IdealFox/Type_C-SSD-Box/复刻文件及说明/复刻文件/相关文档及技术手册/JMS583_cn.jpg

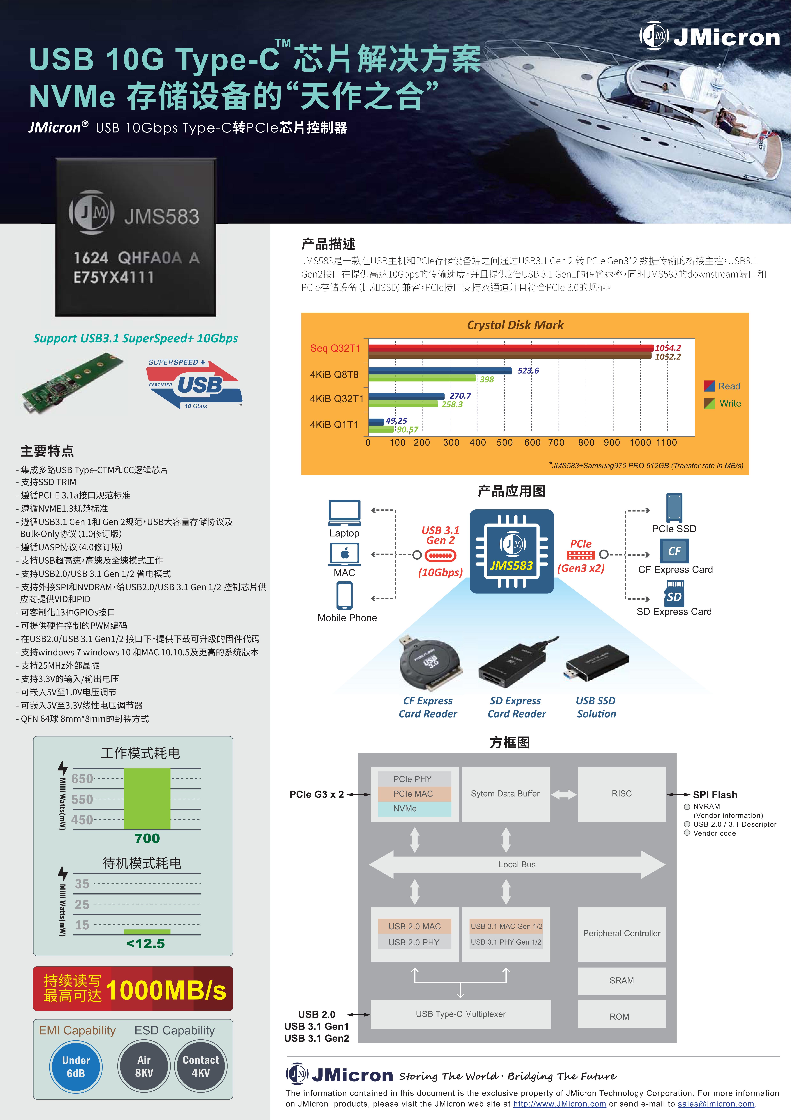
复刻文件及说明/复刻文件/相关文档及技术手册/JMS583_cn.jpg
