IdealFox/Type_C-SSD-Box/复刻文件及说明/复刻文件/所需器件/tb_image_share_1767597438001.png

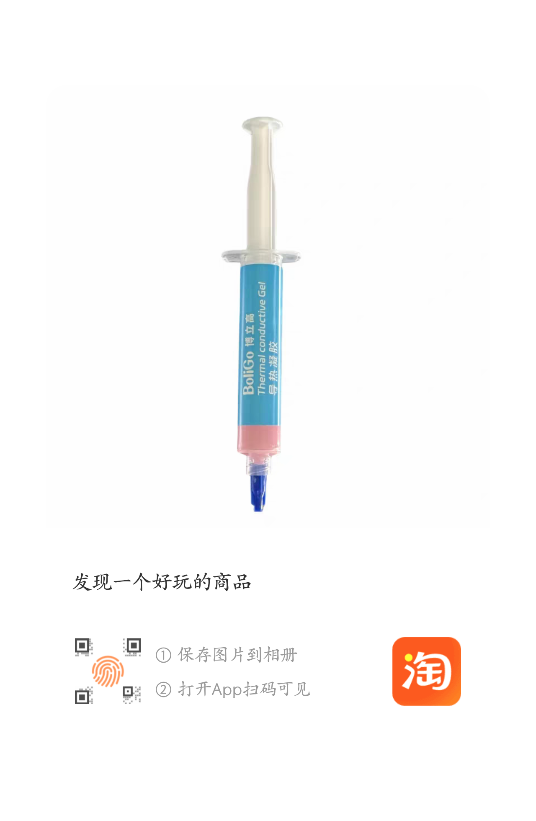
复刻文件及说明/复刻文件/所需器件/tb_image_share_1767597438001.png
