IdealFox/Type_C-SSD-Box/复刻文件及说明/复刻文件/所需器件/tb_image_share_1767601659125.png

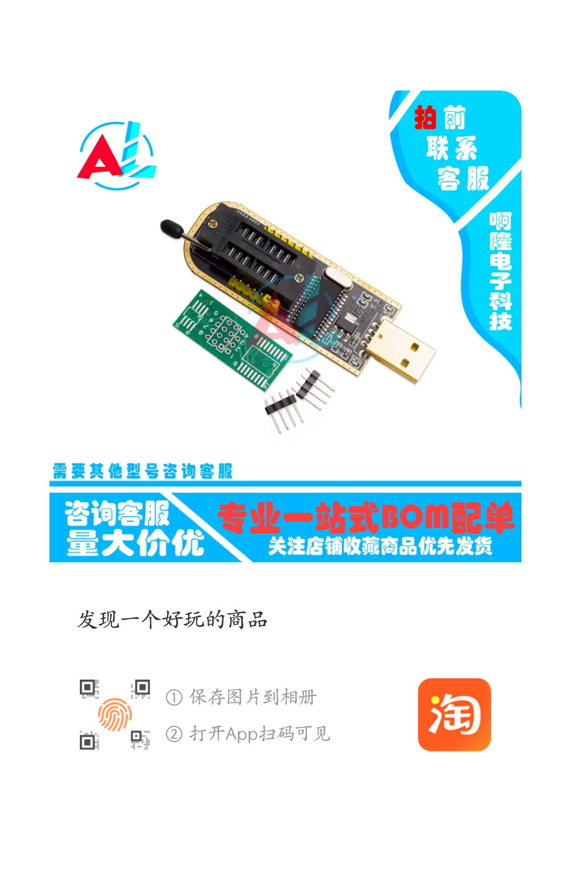
复刻文件及说明/复刻文件/所需器件/tb_image_share_1767601659125.png
