IdealFox/Type_C-SSD-Box/复刻文件及说明/复刻文件/所需器件/_Type_C硬盘盒_2025-09-27_14-32-02-立创_20260105.xls

立创商城BOM报价单
BOM配单编号：BOM260105002363 |  |  |  |  | 上传时间：2026-01-05 14:12:45 |  |  |  | 1.名称释义：MPQ--最小包装量；MOQ--最小起订量； 2.匹配结果为实时查询结果，库存和价格可能会有波动。如超过24小时，请在立创商城重新匹配后下单； 3.订货商品的价格仅供参考，请提交订单后确定。 4.如有部分物料未能成功匹配，需要整单购买，请联系商城客服。
BOM名称：_Type_C硬盘盒_2025-09-27_14-32-02 |  |  |  |  | 采购套数：5
商品总价:￥104.07 (原价:￥107.58, 折扣:-￥3.51) 注：报价单总价不含待确认和无法匹配项 |  |  |  |  | 网址：https://bom.szlcsc.com/bom.html
原始需求 |  |  |  |  |  |  |  |  | 匹配结果 |  |  |  |  |  |  | 订单满足
ID | Name Manufacturer Part | Designator | Footprint | Quantity | Manufacturer Part | Manufacturer | Supplier | Supplier Part | 匹配结果 | 商品名称 | 型号 | 品牌 | 封装 | 参数 | 目录 | 商品编号 | 商品链接 | 渠道 | 交期 | MOQ | MPQ | 库存 | 购买数量 | 单价(RMB) | 关税 | 小计(RMB) | 备注
1 | U261-241N-4BS60 U261-241N-4BS60 | USB1 | USB-TYPE-C-SMD_U261-241N-4BS60 | 1 | U261-241N-4BS60 | XKB Connection(中国星坤) | LCSC | C319150 | 系统匹配 | Type-C 公 夹板 | U261-241N-4BS60 | XKB Connection(中国星坤) | SMD | 连接器类型：Type-C 公母：公 安装方式：夹板 触点数量：24P 端口数量：1 额定电流 - 电源：5A 工作温度：-40℃~+85℃ | 连接器 | C319150 | https://item.szlcsc.com/300242.html | 现货 | 4小时内发货 | 7 | 56 | 6734 | 7 | 1.6926 | 0 | 11.85
2 | JMS583 | U6 | QFN-64_L8.0-W8.0-P0.40-TL-EP6.0 | 1 |  |  |  |  | 无法匹配
3 | MLD-NGFF-M-3.2H MLD-NGFF-M-3.2H | U1 | CONN-SMD_MLD-NGFF-M-3.2H | 1 | MLD-NGFF-M-3.2H | Minlenda(敏连达) | LCSC | C52766481 | 系统匹配 | NGFF M.2 M KEY 3.2H | MLD-NGFF-M-3.2H | Minlenda(敏连达) | SMD |  | 连接器 | C52766481 | https://item.szlcsc.com/55672808.html | 现货 | 4小时内发货 | 1 | 1200 | 1168 | 5 | 2.72 | 0 | 13.60
4 | BLM21PG600SN1D BLM21PG600SN1D | L1 | L0805 | 1 | BLM21PG600SN1D | muRata(村田) | LCSC | C18305 | 系统匹配 | 单路 0805磁珠 阻抗60Ω@100MHz | BLM21PG600SN1D | muRata(村田) | 0805 | 阻抗@频率：60Ω@100MHz 误差：±25% 直流电阻(DCR)：20mΩ | 磁珠/滤波器/EMI优化 | C18305 | https://item.szlcsc.com/19000.html | 现货 | 4小时内发货 | 50 | 4000 | 382500 | 50 | 0.1122 | 0 | 5.61
5 | 10uF CL10A106KP8NNNC | C1,C16,C23,C19,C9,C31,C30,C27,C26,C55 | C0603 | 10 | CL10A106KP8NNNC | SAMSUNG(三星) | LCSC | C19702 | 系统匹配 | 10uF ±10% 10V | CL10A106KP8NNNC | SAMSUNG(三星) | 0603 | 容值：10uF 精度：±10% 额定电压：10V 温度系数：X5R | 电容 | C19702 | https://item.szlcsc.com/20411.html | 现货 | 4小时内发货 | 50 | 4000 | 10975150 | 50 | 0.0369 | 0 | 1.85
6 | 220nF CL05B224KO5NNNC | C12,C13,C14,C15 | C0402 | 4 | CL05B224KO5NNNC | SAMSUNG(三星) | LCSC | C16772 | 系统匹配 | 220nF ±10% 16V | CL05B224KO5NNNC | SAMSUNG(三星) | 0402 | 容值：220nF 精度：±10% 额定电压：16V 温度系数：X7R | 电容 | C16772 | https://item.szlcsc.com/17456.html | 现货 | 4小时内发货 | 100 | 10000 | 474800 | 100 | 0.0277 | 0 | 2.77
7 | 330pF CL05C331JB5NNNC | C4,C5 | C0402 | 2 | CL05C331JB5NNNC | SAMSUNG(三星) | LCSC | C13533 | 系统匹配 | 330pF ±5% 50V | CL05C331JB5NNNC | SAMSUNG(三星) | 0402 | 容值：330pF 精度：±5% 额定电压：50V 温度系数：C0G | 电容 | C13533 | https://item.szlcsc.com/14182.html | 现货 | 4小时内发货 | 50 | 10000 | 156100 | 50 | 0.0186 | 0 | 0.93
8 | 100nF CL05B104KO5NNNC | C6,C7,C10,C11,C46,C47,C45,C44,C43,C42,C50,C49,C48,C53,C52,C51,C24,C20,C37,C38,C35,C39,C36,C32,C29,C28,C25,C17,C3,C18,C56 | C0402 | 31 | CL05B104KO5NNNC | SAMSUNG(三星) | LCSC | C1525 | 系统匹配 | 100nF ±10% 16V | CL05B104KO5NNNC | SAMSUNG(三星) | 0402 | 容值：100nF 精度：±10% 额定电压：16V 温度系数：X7R | 电容 | C1525 | https://item.szlcsc.com/1877.html | 现货 | 4小时内发货 | 100 | 10000 | 25851200 | 200 | 0.0076 | 0 | 1.52
9 | 25MHz XL2EL89CSI-111YLC-25M | X1 | CRYSTAL-SMD_4P-L3.2-W2.5-BL | 1 | XL2EL89CSI-111YLC-25M | YXC(扬兴晶振) | LCSC | C5280577 | 系统匹配 | YSX321SL 25MHZ 4P 3225 20PF ±10PPM -40~85℃ (±20PPM) | XL2EL89CSI-111YLC-25M | YXC(扬兴晶振) | SMD3225-4P | 晶振类型：贴片晶振 频率：25MHz 常温频差：±10ppm 负载电容：20pF 频率稳定度：±20ppm | 振荡器/谐振器 | C5280577 | https://item.szlcsc.com/6016759.html | 现货 | 4小时内发货 | 10 | 3000 | 139070 | 10 | 0.3869 | 0 | 3.87
10 | 20pF 0402CG200J500NT | C8,C2 | C0402 | 2 | 0402CG200J500NT | FH(风华) | LCSC | C1554 | 系统匹配 | 20pF ±5% 50V | 0402CG200J500NT | FH(风华) | 0402 | 容值：20pF 精度：±5% 额定电压：50V 温度系数：C0G | 电容 | C1554 | https://item.szlcsc.com/1906.html | 现货 | 4小时内发货 | 100 | 10000 | 685600 | 100 | 0.0066 | 0 | 0.66
11 | XL-1608PGC-06 XL-1608PGC-06 | U3,U2 | LED0603-RD_GREEN | 2 | XL-1608PGC-06 | XINGLIGHT(成兴光) | LCSC | C7371905 | 系统匹配 | 0603加粉翠绿0.6T贴片式发光二极管 | XL-1608PGC-06 | XINGLIGHT(成兴光) | 0603 | 发光颜色：翠绿色 正向压降(Vf)：2.6V~3V 波长：515nm~530nm 二极管配置：独立二极管 透镜颜色：绿色透镜 发光强度：900mcd 发光角度：120° 载带方式：正贴 | 光电器件 | C7371905 | https://item.szlcsc.com/8342977.html | 现货 | 4小时内发货 | 50 | 20000 | 229350 | 50 | 0.0622 | 0 | 3.11
12 | XL-1608UBC-06A XL-1608UBC-06A | U5 | LED0603-R-RD | 1 | XL-1608UBC-06A | XINGLIGHT(成兴光) | LCSC | C7371904 | 系统匹配 | 0603高亮蓝0.6T贴片式发光二极管 | XL-1608UBC-06A | XINGLIGHT(成兴光) | 0603 | 发光颜色：蓝色 正向压降(Vf)：2.6V~3V 功率：100mW 正向电流：5mA 波长：456nm~476nm 透镜颜色：无色透明透镜 发光强度：300mcd 发光角度：130° 载带方式：正贴 工作温度：-40℃~+85℃ | 光电器件 | C7371904 | https://item.szlcsc.com/8342976.html | 现货 | 4小时内发货 | 50 | 4000 | 83200 | 50 | 0.0777 | 0 | 3.89
13 | 10kΩ 0402WGF1002TCE | R6,R7,R4 | R0402 | 3 | 0402WGF1002TCE | UNI-ROYAL(厚声) | LCSC | C25744 | 系统匹配 | 10kΩ ±1% 62.5mW 厚膜电阻 | 0402WGF1002TCE | UNI-ROYAL(厚声) | 0402 | 电阻类型：厚膜电阻 阻值：10kΩ 精度：±1% 功率：62.5mW 工作电压：50V 温度系数：±100ppm/℃ | 电阻 | C25744 | https://item.szlcsc.com/26487.html | 现货 | 4小时内发货 | 100 | 10000 | 2763700 | 100 | 0.0033 | 0 | 0.33
14 | 4.7kΩ 0402WGF4701TCE | R1,R3 | R0402 | 2 | 0402WGF4701TCE | UNI-ROYAL(厚声) | LCSC | C25900 | 系统匹配 | 4.7kΩ ±1% 62.5mW 厚膜电阻 | 0402WGF4701TCE | UNI-ROYAL(厚声) | 0402 | 电阻类型：厚膜电阻 阻值：4.7kΩ 精度：±1% 功率：62.5mW 工作电压：50V 温度系数：±100ppm/℃ | 电阻 | C25900 | https://item.szlcsc.com/26643.html | 现货 | 4小时内发货 | 100 | 10000 | 6897500 | 100 | 0.0034 | 0 | 0.34
15 | 12kΩ 0402WGF1202TCE | R5 | R0402 | 1 | 0402WGF1202TCE | UNI-ROYAL(厚声) | LCSC | C25752 | 系统匹配 | 12kΩ ±1% 62.5mW 厚膜电阻 | 0402WGF1202TCE | UNI-ROYAL(厚声) | 0402 | 电阻类型：厚膜电阻 阻值：12kΩ 精度：±1% 功率：62.5mW 工作电压：50V 温度系数：±100ppm/℃ | 电阻 | C25752 | https://item.szlcsc.com/26495.html | 现货 | 4小时内发货 | 100 | 10000 | 453900 | 100 | 0.0036 | 0 | 0.36
16 | 4.7uF CL10A475KO8NNNC | C40,C41 | C0603 | 2 | CL10A475KO8NNNC | SAMSUNG(三星) | LCSC | C19666 | 系统匹配 | 4.7uF ±10% 16V | CL10A475KO8NNNC | SAMSUNG(三星) | 0603 | 容值：4.7uF 精度：±10% 额定电压：16V 温度系数：X5R | 电容 | C19666 | https://item.szlcsc.com/20375.html | 现货 | 4小时内发货 | 10 | 4000 | 1390850 | 10 | 0.0612 | 0 | 0.61
17 | 1uF CL10A105KB8NNNC | C34,C33 | C0603 | 2 | CL10A105KB8NNNC | SAMSUNG(三星) | LCSC | C15849 | 系统匹配 | 1uF ±10% 50V | CL10A105KB8NNNC | SAMSUNG(三星) | 0603 | 容值：1uF 精度：±10% 额定电压：50V 温度系数：X5R | 电容 | C15849 | https://item.szlcsc.com/16531.html | 现货 | 4小时内发货 | 50 | 4000 | 9961300 | 50 | 0.0311 | 0 | 1.56
18 | 50kΩ RTT025002FTH | R2 | R0402 | 1 | RTT025002FTH | RALEC(旺诠) | LCSC | C166559 | 系统匹配 | 厚膜电阻 50kΩ ±1% 62.5mW | RTT025002FTH | RALEC(旺诠) | 0402 | 电阻类型：厚膜电阻 阻值：50kΩ 精度：±1% 功率：62.5mW 工作电压：50V 温度系数：±100ppm/℃ | 电阻 | C166559 | https://item.szlcsc.com/177942.html | 现货 | 4小时内发货 | 100 | 10000 | 41000 | 100 | 0.0038 | 0 | 0.38
19 | W25X20CLSNIG W25X20CLSNIG | U4 | SOIC-8_L5.0-W4.0-P1.27-LS6.0-BL | 1 | W25X20CLSNIG | Winbond(华邦) | LCSC | C409019 | 系统匹配 | 具有4KB扇区和双IO SPI接口的2Mbit 串行SPI闪存 | W25X20CLSNIG | Winbond(华邦) | SOIC-8 | 接口类型：SPI 存储容量：2Mbit 时钟频率(fc)：104MHz | 存储器 | C409019 | https://item.szlcsc.com/398848.html | 现货 | 4小时内发货 | 1 | 2500 | 35007 | 5 | 3.25 | 0 | 16.25
20 | ETA3409S2F ETA3409S2F | U8,U7 | SOT-23-5_L2.9-W1.6-P0.95-LS2.8-BL | 2 | ETA3409S2F | ETA(钰泰) | LCSC | C7465553 | 系统匹配 | 3A 1MHz 同步降压转换器 | ETA3409S2F | ETA(钰泰) | SOT23-5 | 功能类型：降压型 工作电压：2.4V~7.3V 输出电压：600mV~7.3V 输出电流：3A 输出类型：可调 | 电源管理 | C7465553 | https://item.szlcsc.com/8507090.html | 现货 | 4小时内发货 | 5 | 3000 | 25055 | 10 | 0.7326 | 0 | 7.33
21 | 2.2uH FTC252012S2R2MBCA | L4,L3 | IND-SMD_L2.5-W2.0_MHCHL2520 | 2 | FTC252012S2R2MBCA | cjiang(长江微电) | LCSC | C5832372 | 系统匹配 | 2.2uH ±20% 3.8A | FTC252012S2R2MBCA | cjiang(长江微电) | 1008 | 电感值：2.2uH 精度：±20% 额定电流：3A 饱和电流(Isat)：3.8A | 电感/线圈/变压器 | C5832372 | https://item.szlcsc.com/6763492.html | 现货 | 4小时内发货 | 20 | 3000 | 420640 | 20 | 0.2046 | 0 | 4.09
22 | 100kΩ 0402WGF1003TCE | R11,R10,R19 | R0402 | 3 | 0402WGF1003TCE | UNI-ROYAL(厚声) | LCSC | C25741 | 系统匹配 | 100kΩ ±1% 62.5mW 厚膜电阻 | 0402WGF1003TCE | UNI-ROYAL(厚声) | 0402 | 电阻类型：厚膜电阻 阻值：100kΩ 精度：±1% 功率：62.5mW 工作电压：50V 温度系数：±100ppm/℃ | 电阻 | C25741 | https://item.szlcsc.com/26484.html | 现货 | 4小时内发货 | 100 | 10000 | 3188300 | 100 | 0.0035 | 0 | 0.35
23 | 22.1kΩ 0402WGF2212TCE | R9 | R0402 | 1 | 0402WGF2212TCE | UNI-ROYAL(厚声) | LCSC | C43473 | 系统匹配 | 22.1kΩ ±1% 62.5mW 厚膜电阻 | 0402WGF2212TCE | UNI-ROYAL(厚声) | 0402 | 电阻类型：厚膜电阻 阻值：22.1kΩ 精度：±1% 功率：62.5mW 工作电压：50V 温度系数：±100ppm/℃ | 电阻 | C43473 | https://item.szlcsc.com/44464.html | 现货 | 4小时内发货 | 100 | 10000 | 171000 | 100 | 0.0035 | 0 | 0.35
24 | 22pF 0402CG220J500NT | C22,C21 | C0402 | 2 | 0402CG220J500NT | FH(风华) | LCSC | C1555 | 系统匹配 | 22pF ±5% 50V | 0402CG220J500NT | FH(风华) | 0402 | 容值：22pF 精度：±5% 额定电压：50V 温度系数：C0G | 电容 | C1555 | https://item.szlcsc.com/1907.html | 现货 | 4小时内发货 | 100 | 10000 | 752900 | 100 | 0.0065 | 0 | 0.65
25 | ZX-PZ1.0-1-4PZZ ZX-PZ1.0-1-4PZZ | H1 | HDR-TH_ZX-PZ1.0-1-4PZZ | 1 | ZX-PZ1.0-1-4PZZ | Megastar(兆星) | LCSC | C37328854 | 系统匹配 | 1x4P 间距:1mm 方针 直插 | ZX-PZ1.0-1-4PZZ | Megastar(兆星) | 插件,P=1mm | 插针结构：1x4P 间距：1mm 圆针/方针：方针 安装方式：直插 排数：单排 总PIN位数：4P 额定电流：750mA 配合针长度：2mm 塑高：1mm 端接针长度：2mm 触头材质：黄铜 触头镀层：金 工作温度：-40℃~+105℃ 颜色：黑色 | 连接器 | C37328854 | https://item.szlcsc.com/39053335.html | 现货 | 4小时内发货 | 5 | 2000 | 6435 | 5 | 0.31939 | 0 | 1.60
26 | 150kΩ 0402WGF1503TCE | R8 | R0402 | 1 | 0402WGF1503TCE | UNI-ROYAL(厚声) | LCSC | C25755 | 系统匹配 | 150kΩ ±1% 62.5mW 厚膜电阻 | 0402WGF1503TCE | UNI-ROYAL(厚声) | 0402 | 电阻类型：厚膜电阻 阻值：150kΩ 精度：±1% 功率：62.5mW 工作电压：50V 温度系数：±100ppm/℃ | 电阻 | C25755 | https://item.szlcsc.com/26498.html | 现货 | 4小时内发货 | 100 | 10000 | 318200 | 100 | 0.0035 | 0 | 0.35
27 | 4.7uH FTC252010S4R7MBCA | L2 | IND-SMD_L2.5-W2.0-VLS252012CX-150M | 1 | FTC252010S4R7MBCA | cjiang(长江微电) | LCSC | C5832360 | 系统匹配 | 4.7uH ±20% 2.6A | FTC252010S4R7MBCA | cjiang(长江微电) | 1008 | 电感值：4.7uH 精度：±20% 额定电流：2A 饱和电流(Isat)：2.6A | 电感/线圈/变压器 | C5832360 | https://item.szlcsc.com/6763480.html | 现货 | 4小时内发货 | 20 | 3000 | 448440 | 20 | 0.2145 | 0 | 4.29
28 | 0Ω 0402WGF0000TCE | R12,R13 | R0402 | 2 | 0402WGF0000TCE | UNI-ROYAL(厚声) | LCSC | C17168 | 系统匹配 | 0Ω ±1% 62.5mW 厚膜电阻 | 0402WGF0000TCE | UNI-ROYAL(厚声) | 0402 | 电阻类型：厚膜电阻 阻值：0Ω 精度：±1% 功率：62.5mW 工作电压：50V 温度系数：±800ppm/℃ | 电阻 | C17168 | https://item.szlcsc.com/17853.html | 现货 | 4小时内发货 | 100 | 10000 | 2701300 | 100 | 0.0034 | 0 | 0.34
29 | TMP709AIDBVR(UMW) TMP709AIDBVR(UMW) | U9 | SOT-23-5_L3.0-W1.5-P0.95-LS2.8-BL | 1 | TMP709AIDBVR(UMW) | UMW(友台半导体) | LCSC | C22396387 | 系统匹配 | 温度开关 | TMP709AIDBVR(UMW) | UMW(友台半导体) | SOT-23-5 |  | 传感器 | C22396387 | https://item.szlcsc.com/24000858.html | 现货 | 4小时内发货 | 5 | 3000 | 1145 | 5 | 1.3336 | 0 | 6.67
30 | 56kΩ 0402WGF5602TCE | R14 | R0402 | 1 | 0402WGF5602TCE | UNI-ROYAL(厚声) | LCSC | C25796 | 系统匹配 | 56kΩ ±1% 62.5mW 厚膜电阻 | 0402WGF5602TCE | UNI-ROYAL(厚声) | 0402 | 电阻类型：厚膜电阻 阻值：56kΩ 精度：±1% 功率：62.5mW 工作电压：50V 温度系数：±100ppm/℃ | 电阻 | C25796 | https://item.szlcsc.com/26539.html | 现货 | 4小时内发货 | 100 | 10000 | 129700 | 100 | 0.0036 | 0 | 0.36
31 | 470kΩ 0402WGF4703TCE | R15 | R0402 | 1 | 0402WGF4703TCE | UNI-ROYAL(厚声) | LCSC | C25790 | 系统匹配 | 470kΩ ±1% 62.5mW 厚膜电阻 | 0402WGF4703TCE | UNI-ROYAL(厚声) | 0402 | 电阻类型：厚膜电阻 阻值：470kΩ 精度：±1% 功率：62.5mW 工作电压：50V 温度系数：±100ppm/℃ | 电阻 | C25790 | https://item.szlcsc.com/26533.html | 现货 | 4小时内发货 | 100 | 10000 | 161200 | 100 | 0.0035 | 0 | 0.35
32 | HL3401A HL3401A | Q2 | SOT-23-3_L2.9-W1.3-P1.90-LS2.4-BR | 1 | HL3401A | R+O(宏嘉诚) | LCSC | C7420349 | 系统匹配 | 1个P沟道 耐压:30V 电流:4.2A | HL3401A | R+O(宏嘉诚) | SOT-23 | 数量：1个P沟道 漏源电压(Vdss)：30V 连续漏极电流(Id)：4.2A 导通电阻(RDS(on))：50mΩ@10V 耗散功率(Pd)：350mW 阈值电压(Vgs(th))：900mV@250uA | 三极管/MOS管/晶体管 | C7420349 | https://item.szlcsc.com/8397171.html | 现货 | 4小时内发货 | 10 | 3000 | 77230 | 10 | 0.2188 | 0 | 2.19
33 | FR107W FR107W | D1 | SOD-123FL_L2.7-W1.8-LS3.8-RD | 1 | FR107W | R+O(宏嘉诚) | LCSC | C18199114 | 系统匹配 | 耐压:1000V 电流:1A 反向恢复时间：500ns | FR107W | R+O(宏嘉诚) | SOD-123FL | 二极管配置：独立式 正向压降(Vf)：1.3V@1.0A 直流反向耐压(Vr)：1kV 整流电流：1A 反向恢复时间(Trr)：500ns | 二极管 | C18199114 | https://item.szlcsc.com/19354346.html | 现货 | 4小时内发货 | 50 | 3000 | 75050 | 50 | 0.0502 | 0 | 2.51
34 | 150Ω 0402WGF1500TCE | R16 | R0402 | 1 | 0402WGF1500TCE | UNI-ROYAL(厚声) | LCSC | C25082 | 系统匹配 | 150Ω ±1% 62.5mW 厚膜电阻 | 0402WGF1500TCE | UNI-ROYAL(厚声) | 0402 | 电阻类型：厚膜电阻 阻值：150Ω 精度：±1% 功率：62.5mW 工作电压：50V 温度系数：±100ppm/℃ | 电阻 | C25082 | https://item.szlcsc.com/25825.html | 现货 | 4小时内发货 | 100 | 10000 | 249400 | 100 | 0.0038 | 0 | 0.38
35 | ZX-SH1.0-2PWT ZX-SH1.0-2PWT | U10 | CONN-SMD_2P-P1.00_HX-1.0-2P-WT | 1 | ZX-SH1.0-2PWT | Megastar(兆星) | LCSC | C7430444 | 系统匹配 | 1x2P 间距:1mm 卧贴 系列:SH | ZX-SH1.0-2PWT | Megastar(兆星) | SMD,P=1mm,卧贴 | 插针结构：1x2P 间距：1mm 安装方式：卧贴 参考系列：SH 总PIN数：2P 排数：1 每排PIN数：2 额定电流：1A 触头材质：黄铜 触头镀层：锡 工作温度：-40℃~+85℃ | 连接器 | C7430444 | https://item.szlcsc.com/8430313.html | 现货 | 4小时内发货 | 10 | 2000 | 26350 | 10 | 0.286045 | 0 | 2.86
36 | 50Ω RT0402BRE0750RL | R17,R18 | R0402 | 2 | RT0402BRE0750RL | YAGEO(国巨) | LCSC | C853312 | 系统匹配 | 薄膜电阻 50Ω ±0.1% 62.5mW | RT0402BRE0750RL | YAGEO(国巨) | 0402 | 电阻类型：薄膜电阻 阻值：50Ω 精度：±0.1% 功率：62.5mW 工作电压：50V 温度系数：±50ppm/℃ | 电阻 | C853312 | https://item.szlcsc.com/913634.html | 现货 | 4小时内发货 | 20 | 10000 | 55320 | 20 | 0.142 | 0 | 2.84
37 | 200kΩ 0402WGF2003TCE | R20 | R0402 | 1 | 0402WGF2003TCE | UNI-ROYAL(厚声) | LCSC | C25764 | 系统匹配 | 200kΩ ±1% 62.5mW 厚膜电阻 | 0402WGF2003TCE | UNI-ROYAL(厚声) | 0402 | 电阻类型：厚膜电阻 阻值：200kΩ 精度：±1% 功率：62.5mW 工作电压：50V 温度系数：±100ppm/℃ | 电阻 | C25764 | https://item.szlcsc.com/26507.html | 现货 | 4小时内发货 | 100 | 10000 | 1057600 | 100 | 0.0035 | 0 | 0.35
