IdealFox/Type_C-SSD-Box/外壳与装配模型/正压底部直吹风道_v3.0/装配体.SLDASM

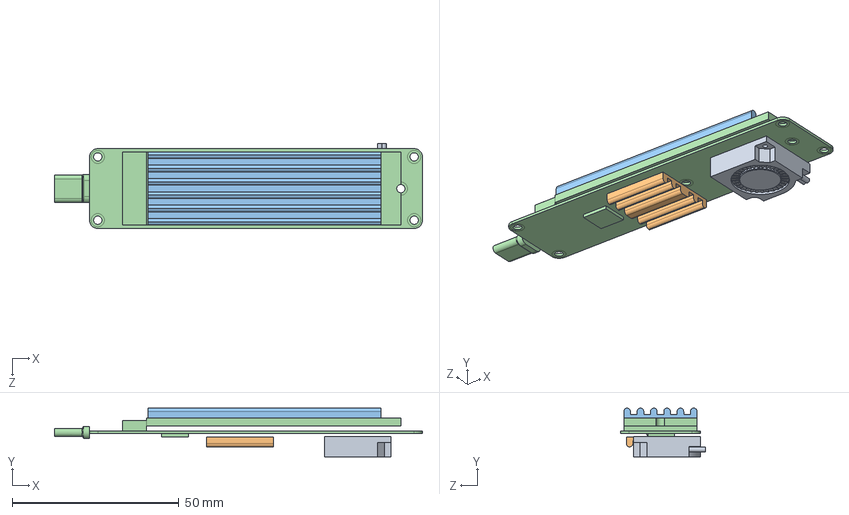
[picture p91: CAD file, 2026-01-07]
外壳与装配模型/正压底部直吹风道_v3.0/装配体.SLDASM
110.5 x 14.7 x 25.5 mm
1_PCB板
2_硬盘散热片
3_主控散热片
3_散热风扇
