IdealFox/Type_C-SSD-Box/复刻文件及说明/复刻文件/外壳模型/底部直吹风道_v3.0/5_壳体.STEP

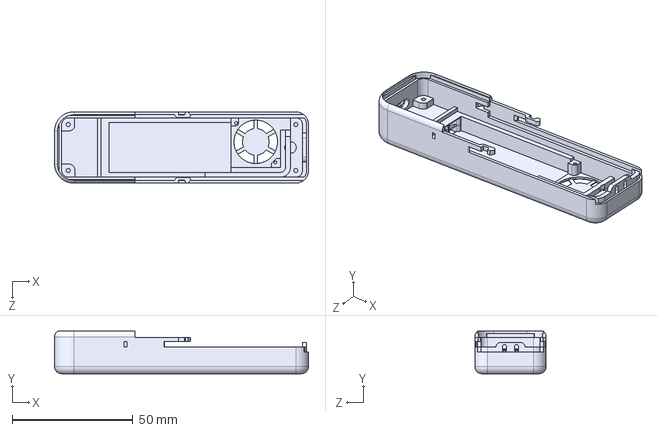
[picture p92: CAD file, 2026-01-07]
复刻文件及说明/复刻文件/外壳模型/底部直吹风道_v3.0/5_壳体.STEP
105.1 x 17.6 x 29.5 mm
