IdealFox/Type_C-SSD-Box/外壳与装配模型/正压底通顶风道_v1.2/3_散热风扇.SLDPRT

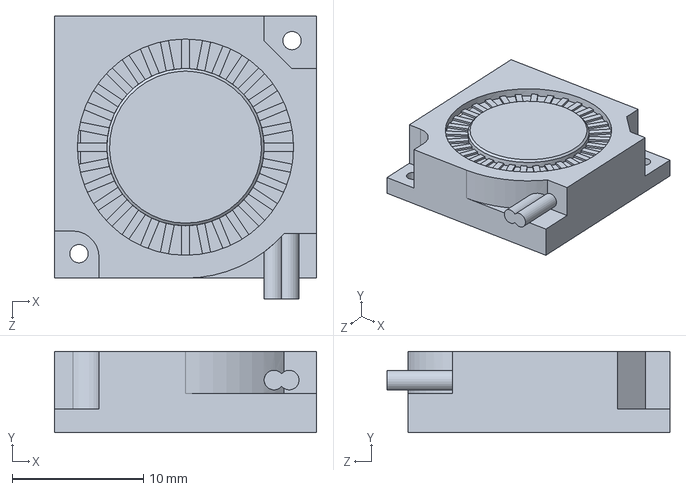
[picture p93: CAD file, 2026-01-07]
外壳与装配模型/正压底通顶风道_v1.2/3_散热风扇.SLDPRT
20.0 x 6.20 x 21.6 mm
