IdealFox/Type_C-SSD-Box/外壳与装配模型/正压底部直吹风道_v3.0/2_硬盘散热片.SLDPRT

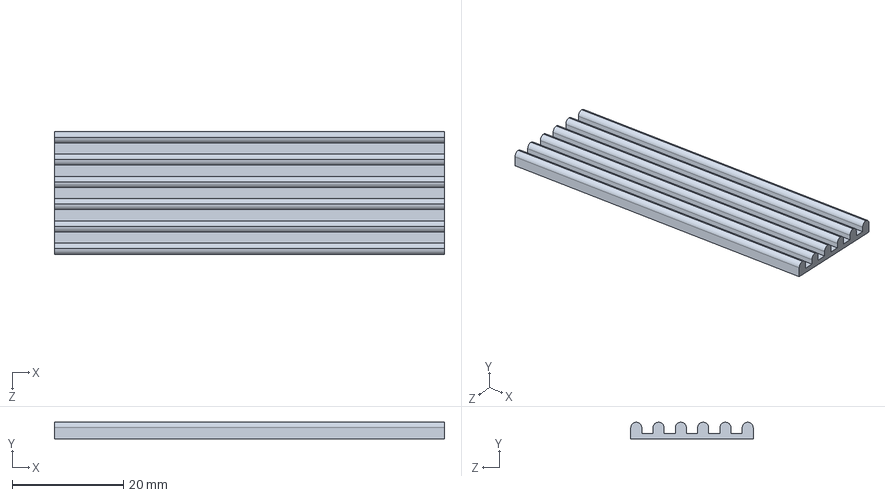
[picture p94: CAD file, 2026-01-07]
外壳与装配模型/正压底部直吹风道_v3.0/2_硬盘散热片.SLDPRT
70.0 x 3.00 x 22.0 mm
