IdealFox/Type_C-SSD-Box/复刻文件及说明/复刻文件/外壳模型/底部直吹风道_v3.0/6_盖板.STEP

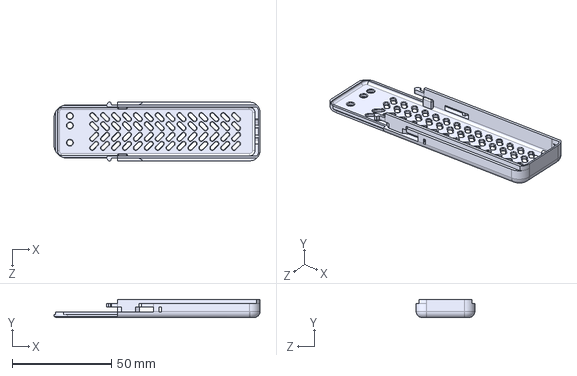
[picture p95: CAD file, 2026-01-07]
复刻文件及说明/复刻文件/外壳模型/底部直吹风道_v3.0/6_盖板.STEP
103.7 x 9.10 x 29.5 mm
