IdealFox/Type_C-SSD-Box/外壳与装配模型/正压底通顶风道_v1.2/6_盖板.step.SLDPRT

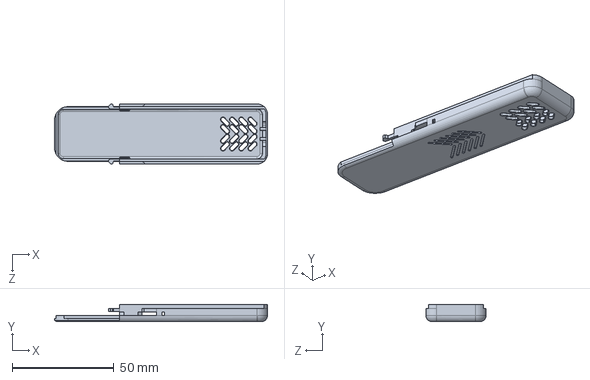
[picture p96: CAD file, 2026-01-07]
外壳与装配模型/正压底通顶风道_v1.2/6_盖板.step.SLDPRT
104.7 x 8.50 x 29.5 mm
