IdealFox/Type_C-SSD-Box/外壳与装配模型/正压底通顶风道_v1.2/3_主控散热片.SLDPRT

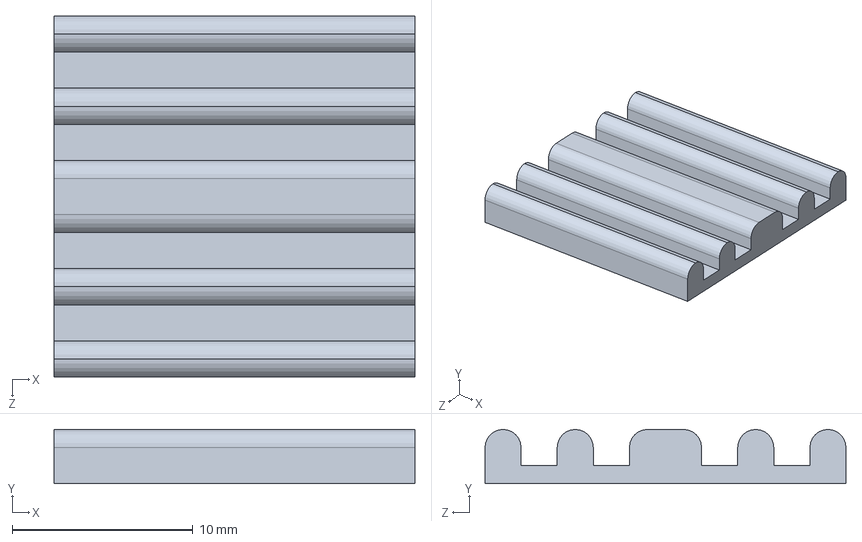
[picture p97: CAD file, 2026-01-07]
外壳与装配模型/正压底通顶风道_v1.2/3_主控散热片.SLDPRT
20.0 x 3.00 x 20.0 mm
