IdealFox/Type_C-SSD-Box/外壳与装配模型/正压底通顶风道_v1.2/5_壳体.STEP

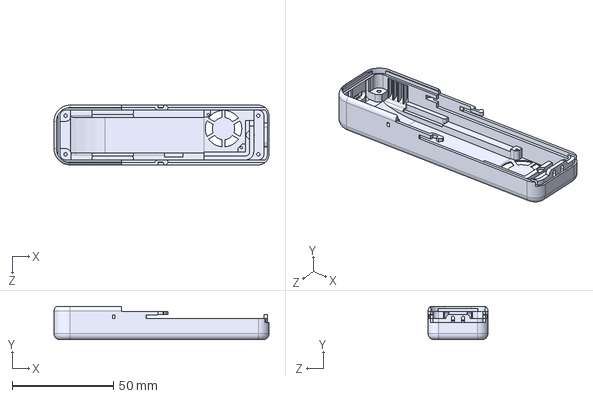
[picture p98: CAD file, 2026-01-07]
外壳与装配模型/正压底通顶风道_v1.2/5_壳体.STEP
106.0 x 16.5 x 29.5 mm
