IdealFox/Type_C-SSD-Box/外壳与装配模型/正压底部直吹风道_v3.0/3_主控散热片.SLDPRT

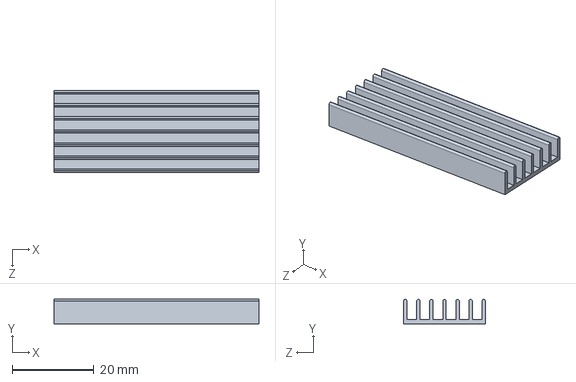
[picture p99: CAD file, 2026-01-07]
外壳与装配模型/正压底部直吹风道_v3.0/3_主控散热片.SLDPRT
50.0 x 5.99 x 20.0 mm
