IdealFox/Type_C-SSD-Box/外壳与装配模型/正压底部直吹风道_v3.0/铰链杆子2.SLDPRT

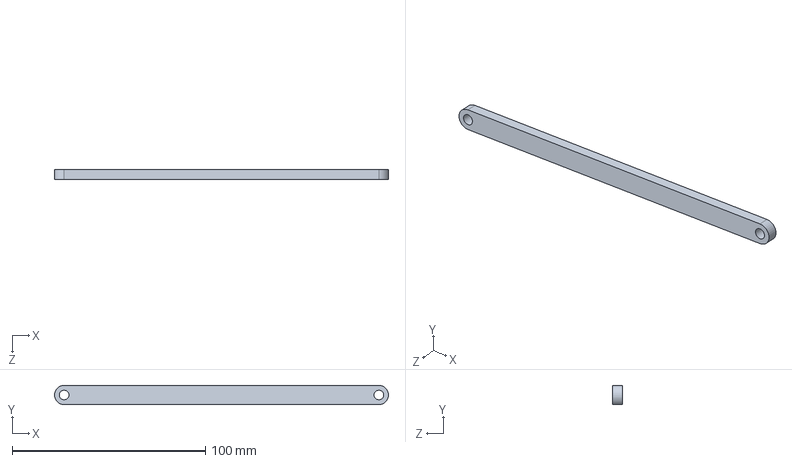
[picture p100: CAD file, 2026-01-07]
外壳与装配模型/正压底部直吹风道_v3.0/铰链杆子2.SLDPRT
173.0 x 10.0 x 5.00 mm
