IdealFox/Type_C-SSD-Box/外壳与装配模型/正压底部直吹风道_v3.0/1_PCB板.SLDPRT

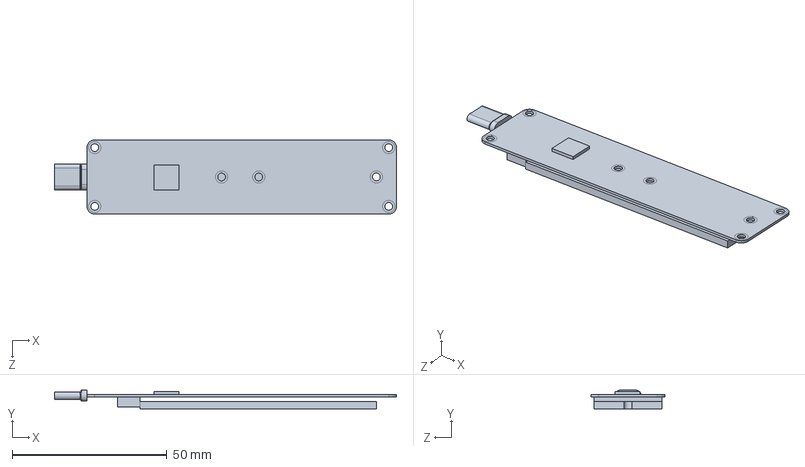
[picture p101: CAD file, 2026-01-07]
外壳与装配模型/正压底部直吹风道_v3.0/1_PCB板.SLDPRT
110.5 x 6.07 x 24.0 mm
