IdealFox/Type_C-SSD-Box/外壳与装配模型/正压底部直吹风道_v3.0/铰链杆子3.SLDPRT

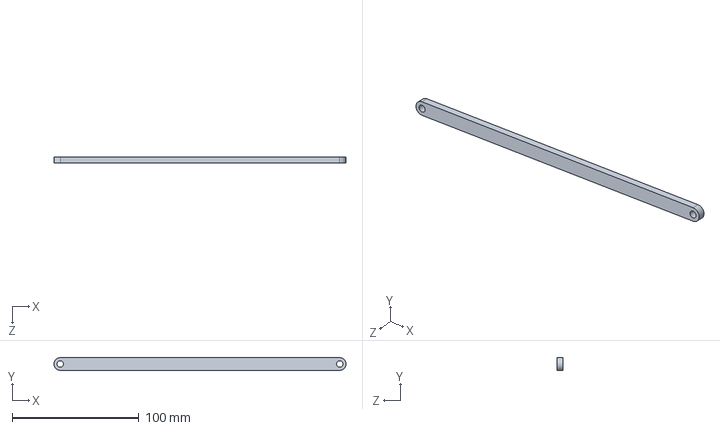
[picture p102: CAD file, 2026-01-07]
外壳与装配模型/正压底部直吹风道_v3.0/铰链杆子3.SLDPRT
229.9 x 10.0 x 5.00 mm
