IdealFox/Type_C-SSD-Box/外壳与装配模型/正压底部直吹风道_v3.0/铰链杆子1.SLDPRT

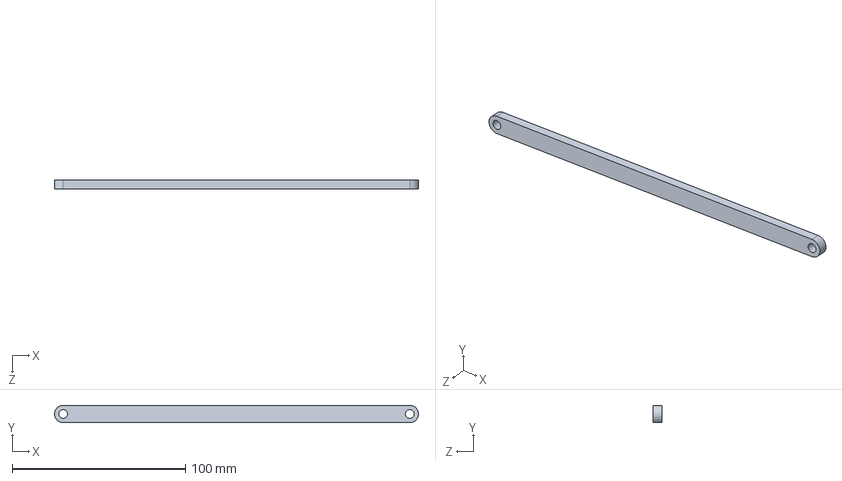
[picture p103: CAD file, 2026-01-07]
外壳与装配模型/正压底部直吹风道_v3.0/铰链杆子1.SLDPRT
209.9 x 10.0 x 5.00 mm
