IdealFox/Type_C-SSD-Box/(list of files, cad)

Other CAD files:
外壳与装配模型/正压底通顶风道_v1.2/装配体.SLDASM
PCB工程/ver3.0/板框.dwg
外壳与装配模型/正压底通顶风道_v1.2/6_盖板.STEP
外壳与装配模型/正压底通顶风道_v1.2/1_PCB板.SLDPRT
PCB工程/ver1.0/板框.dwg
PCB工程/ver2.0/板框.dwg
外壳与装配模型/正压底通顶风道_v1.2/5_壳体.SLDPRT
外壳与装配模型/正压底通顶风道_v1.2/6_盖板.SLDPRT
外壳与装配模型/正压底部直吹风道_v2.0/1_PCB板.SLDPRT
外壳与装配模型/正压底部直吹风道_v2.0/5_壳体.SLDPRT
外壳与装配模型/正压底部直吹风道_v2.0/5_壳体.STEP
外壳与装配模型/正压底部直吹风道_v2.0/6_盖板.SLDPRT
外壳与装配模型/正压底部直吹风道_v2.0/6_盖板.STEP
外壳与装配模型/正压底部直吹风道_v2.0/装配体.SLDASM
外壳与装配模型/正压底部直吹风道_v2.1/1_PCB板.SLDPRT
外壳与装配模型/正压底部直吹风道_v2.1/5_壳体.SLDPRT
外壳与装配模型/正压底部直吹风道_v2.1/5_壳体.STEP
外壳与装配模型/正压底部直吹风道_v2.1/6_盖板.SLDPRT
外壳与装配模型/正压底部直吹风道_v2.1/6_盖板.STEP
外壳与装配模型/正压底部直吹风道_v2.1/装配体.SLDASM
外壳与装配模型/正压底部直吹风道_v3.0/5_壳体.SLDPRT
外壳与装配模型/正压底部直吹风道_v3.0/6_盖板.SLDPRT
