IdealFox/Type_C-SSD-Box/复刻文件及说明/复刻文件/相关文档及技术手册/E5280E40E542625C5F46F982007C9B56.pdf

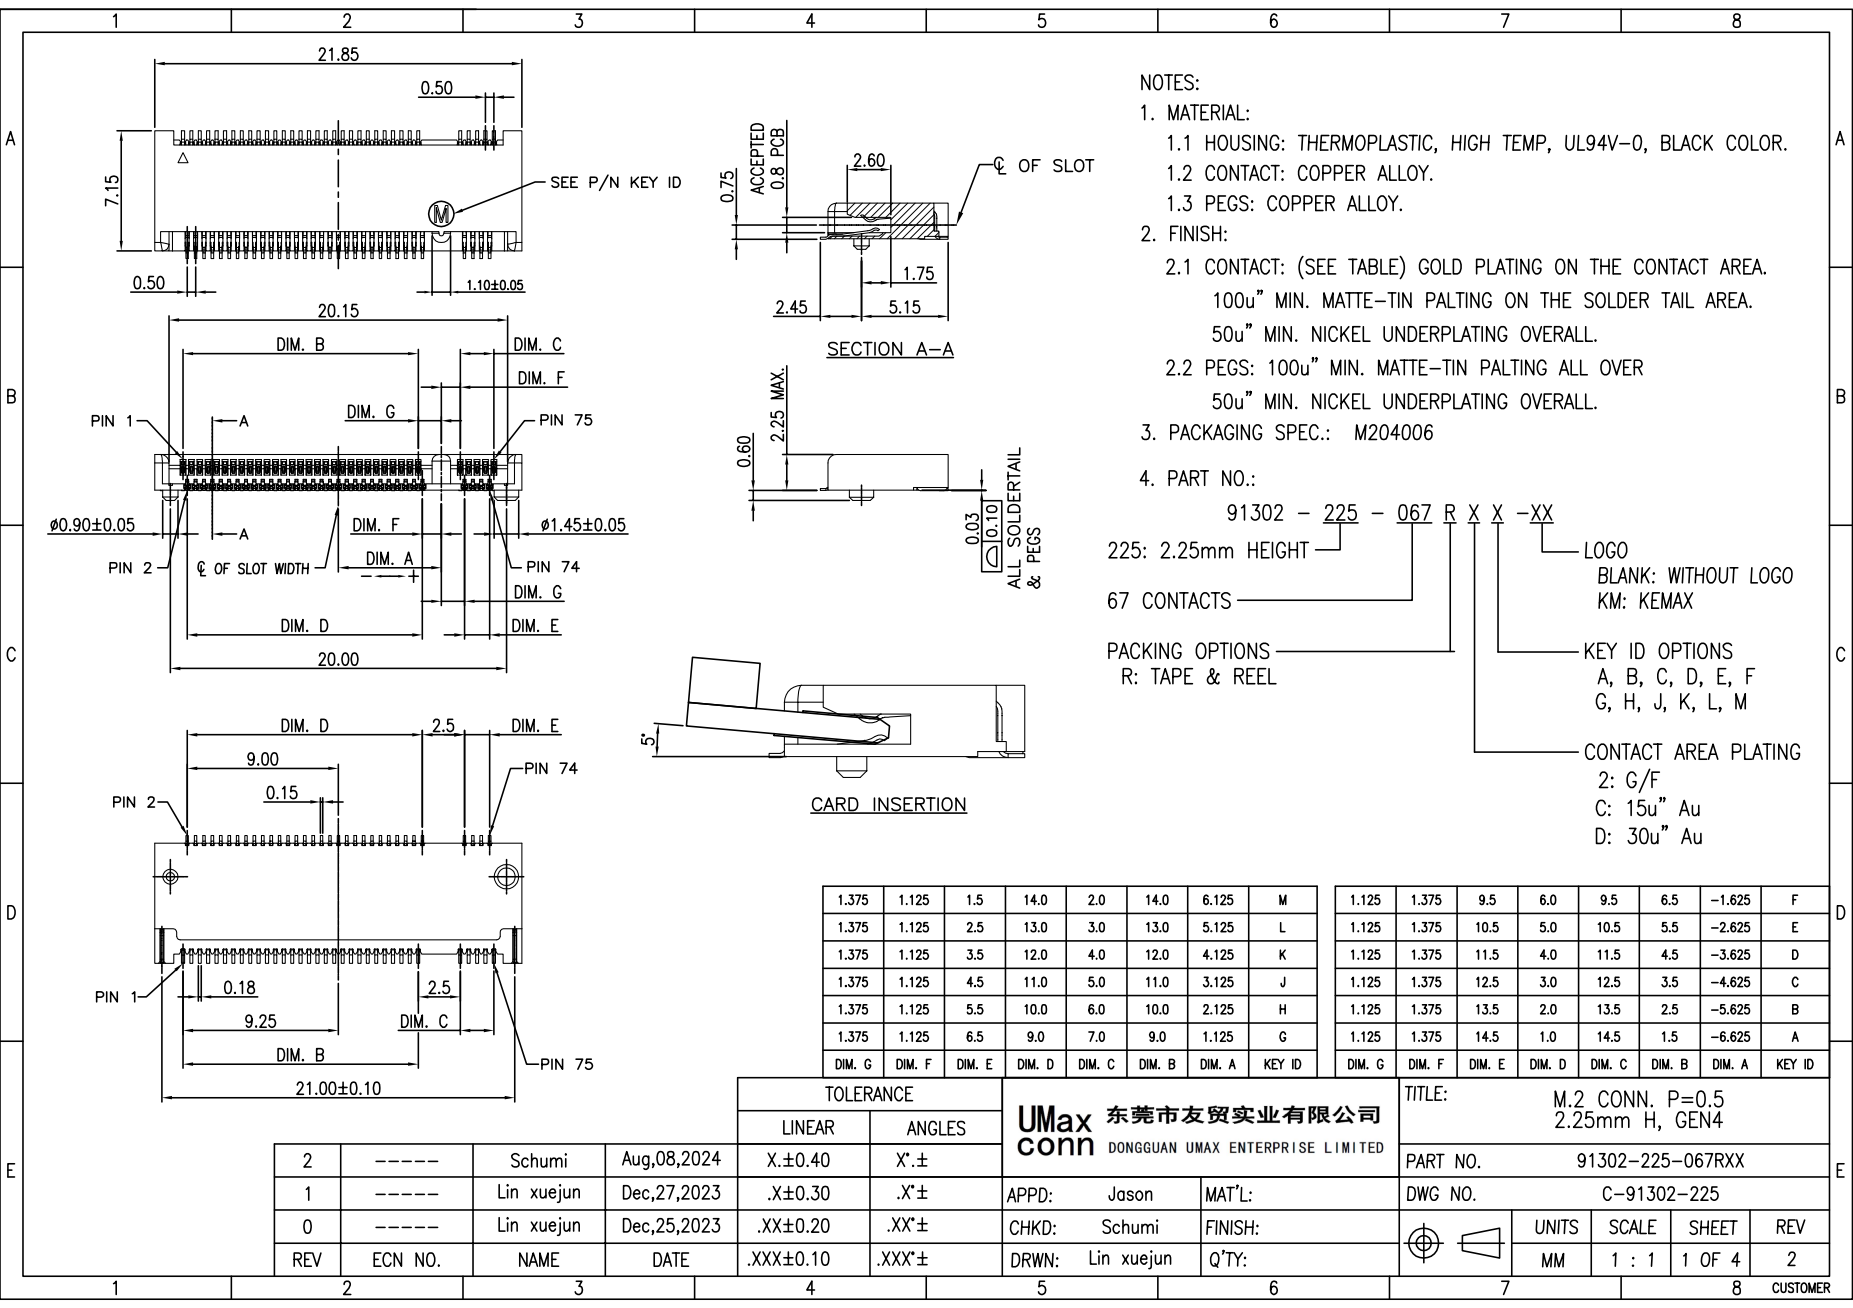
[picture p104: page 1]

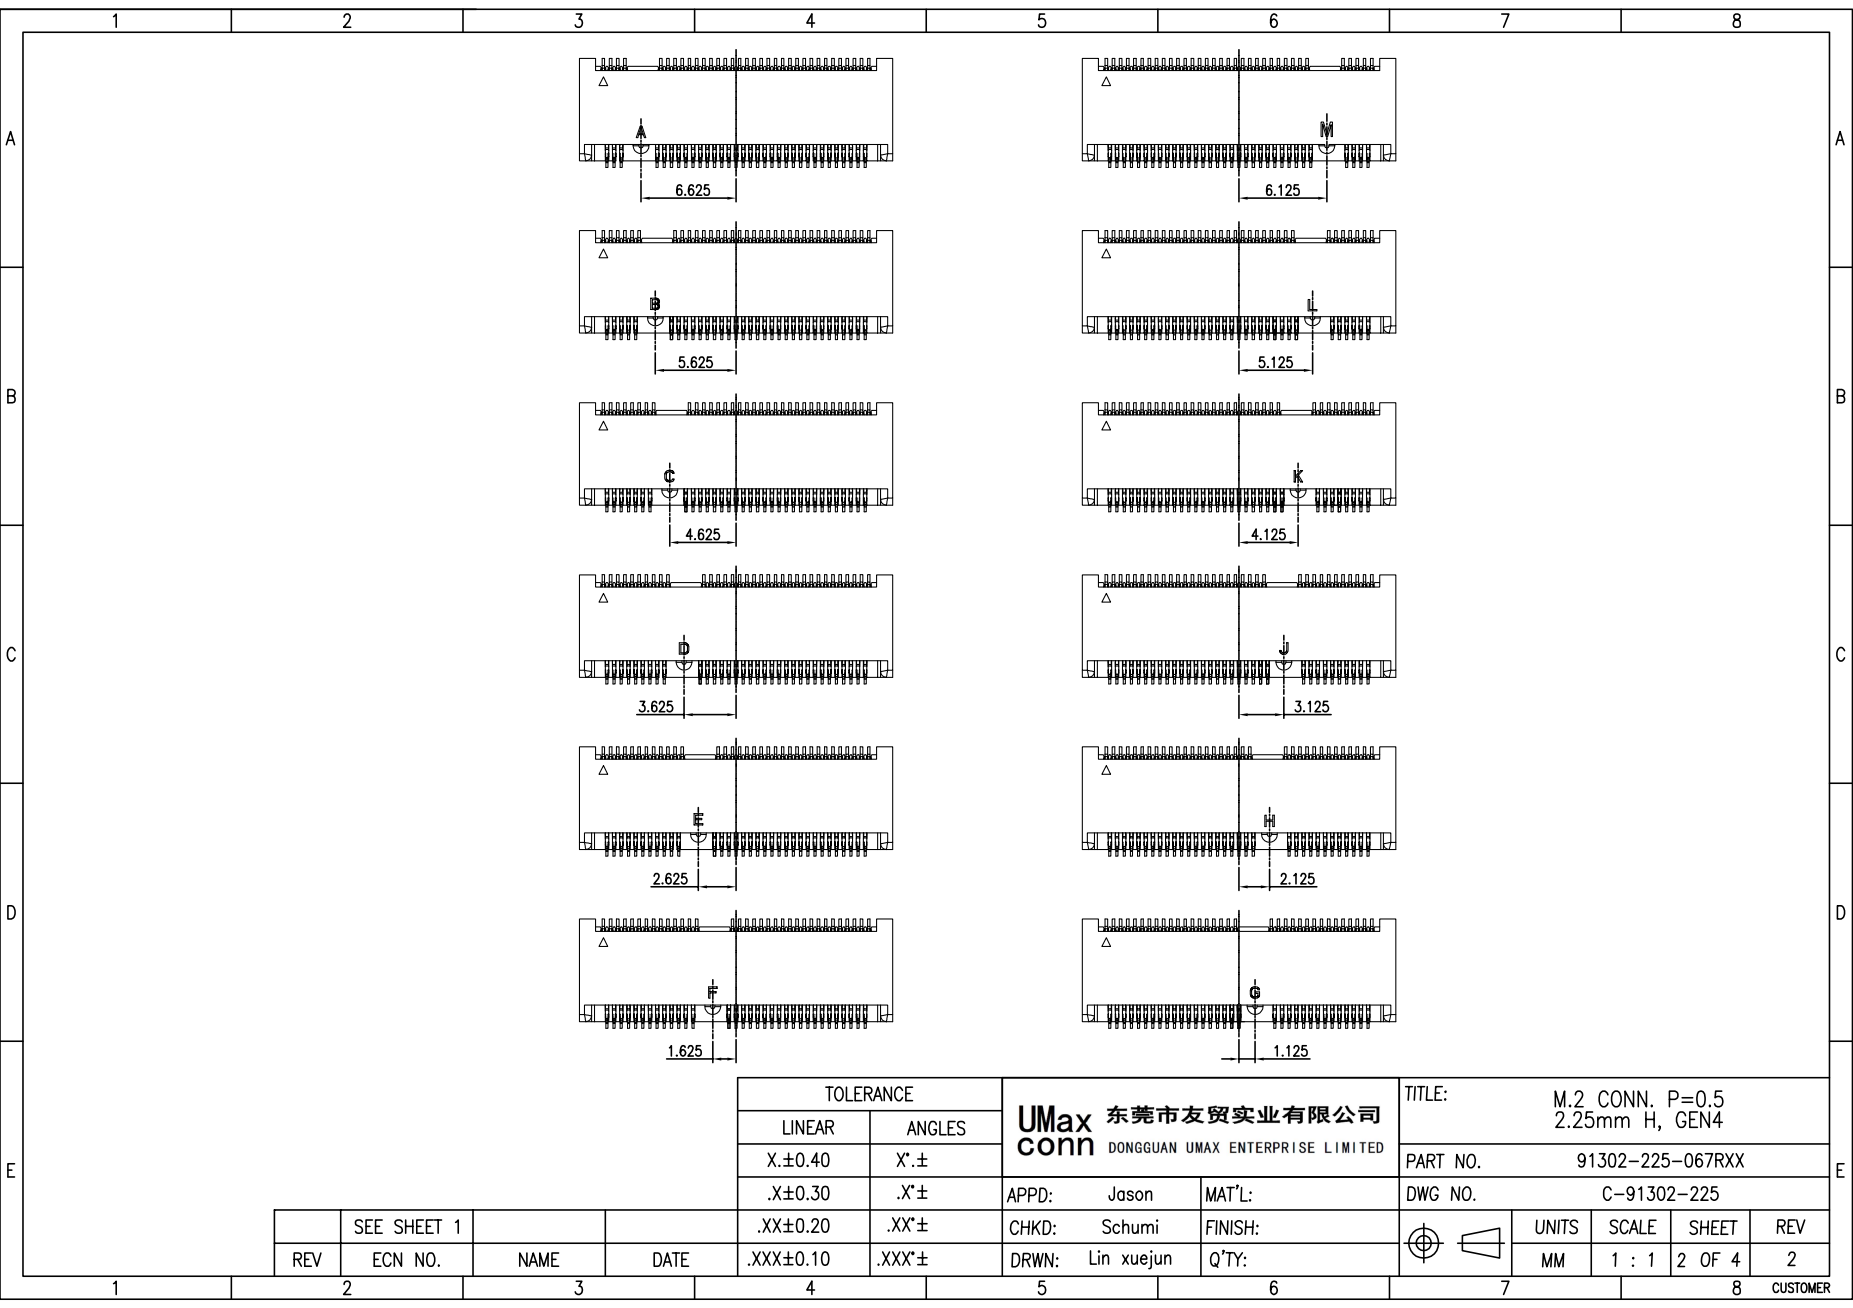
[picture p105: page 2]

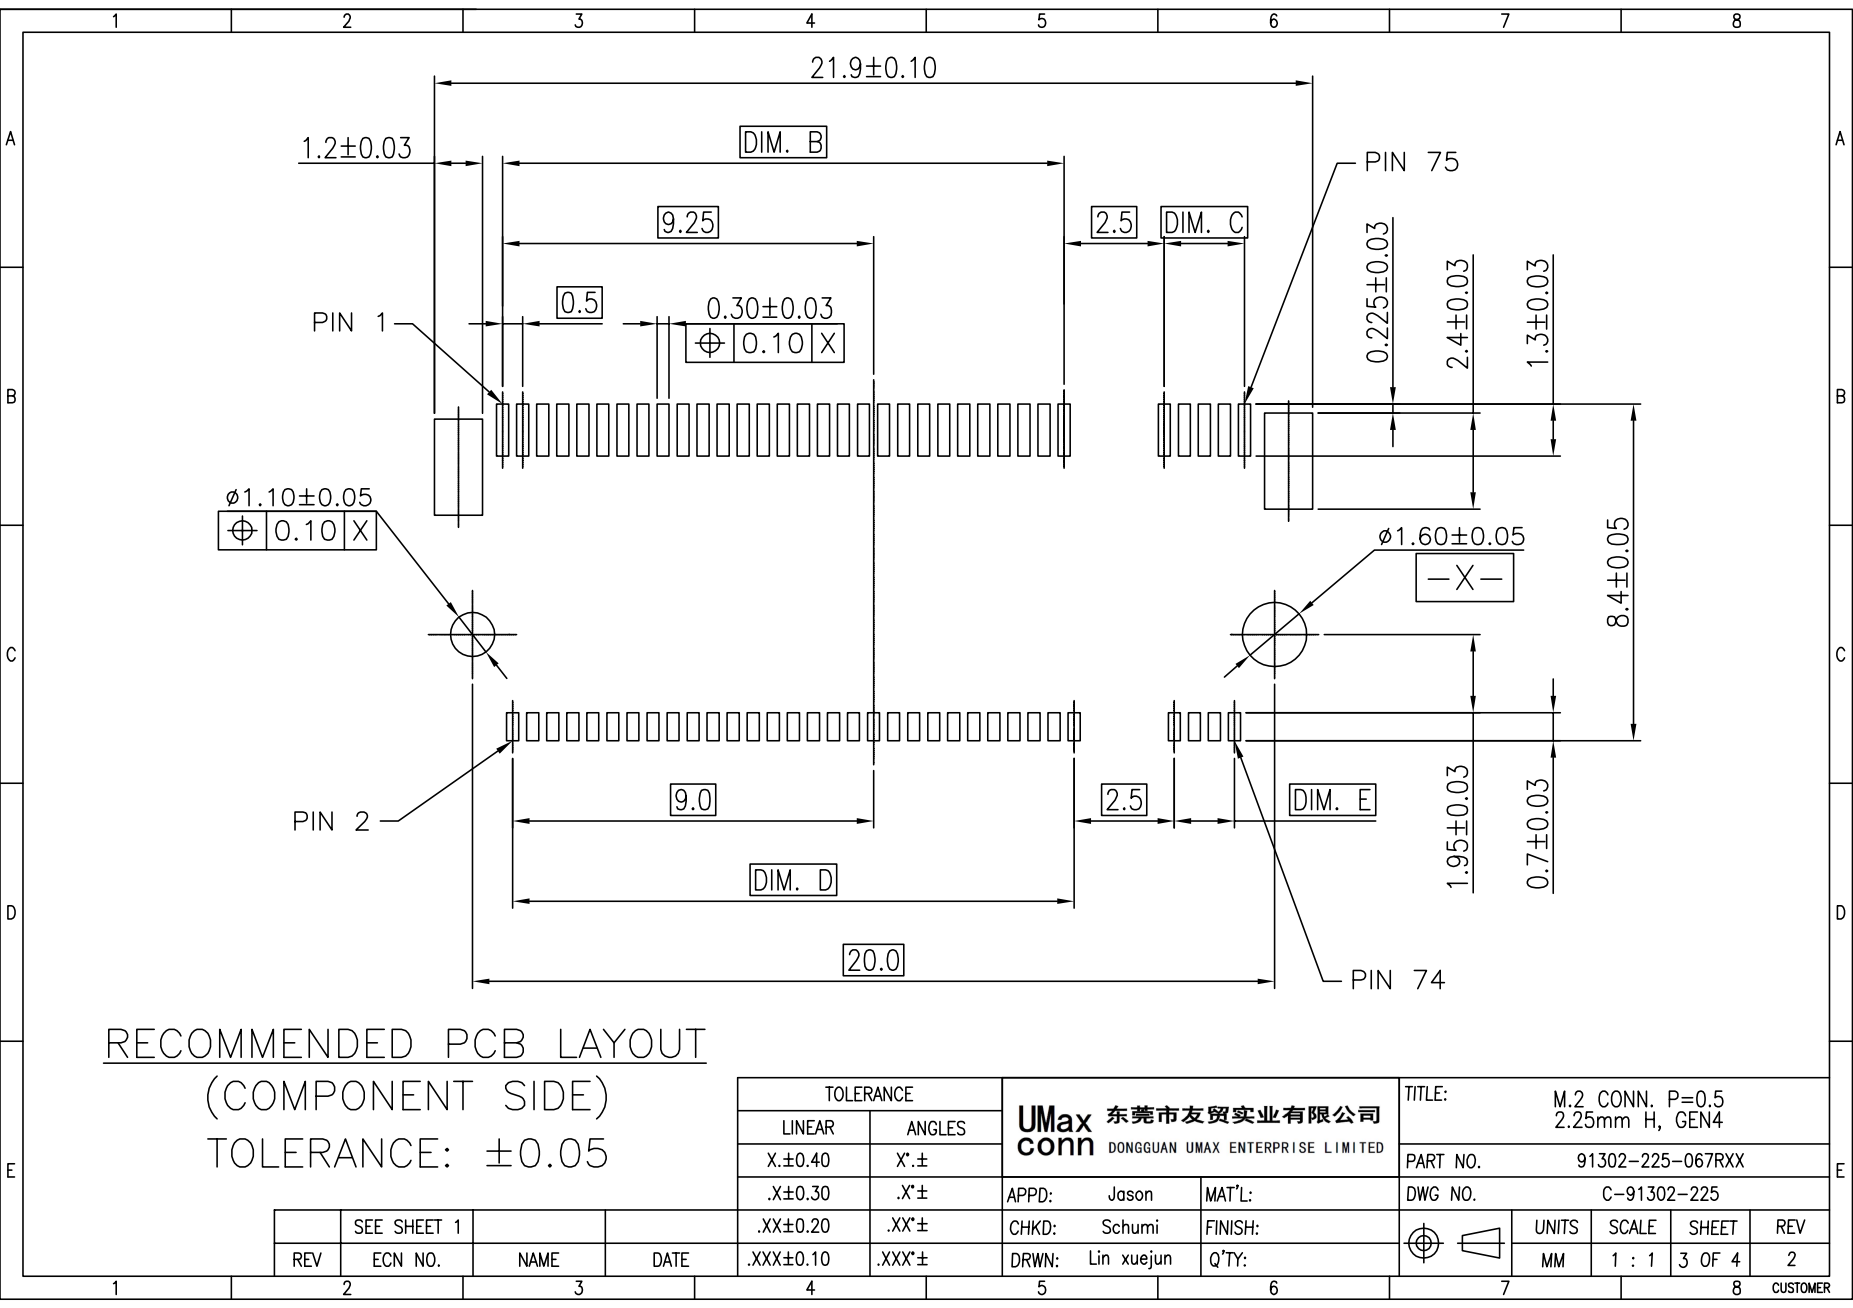
[picture p106: page 3]

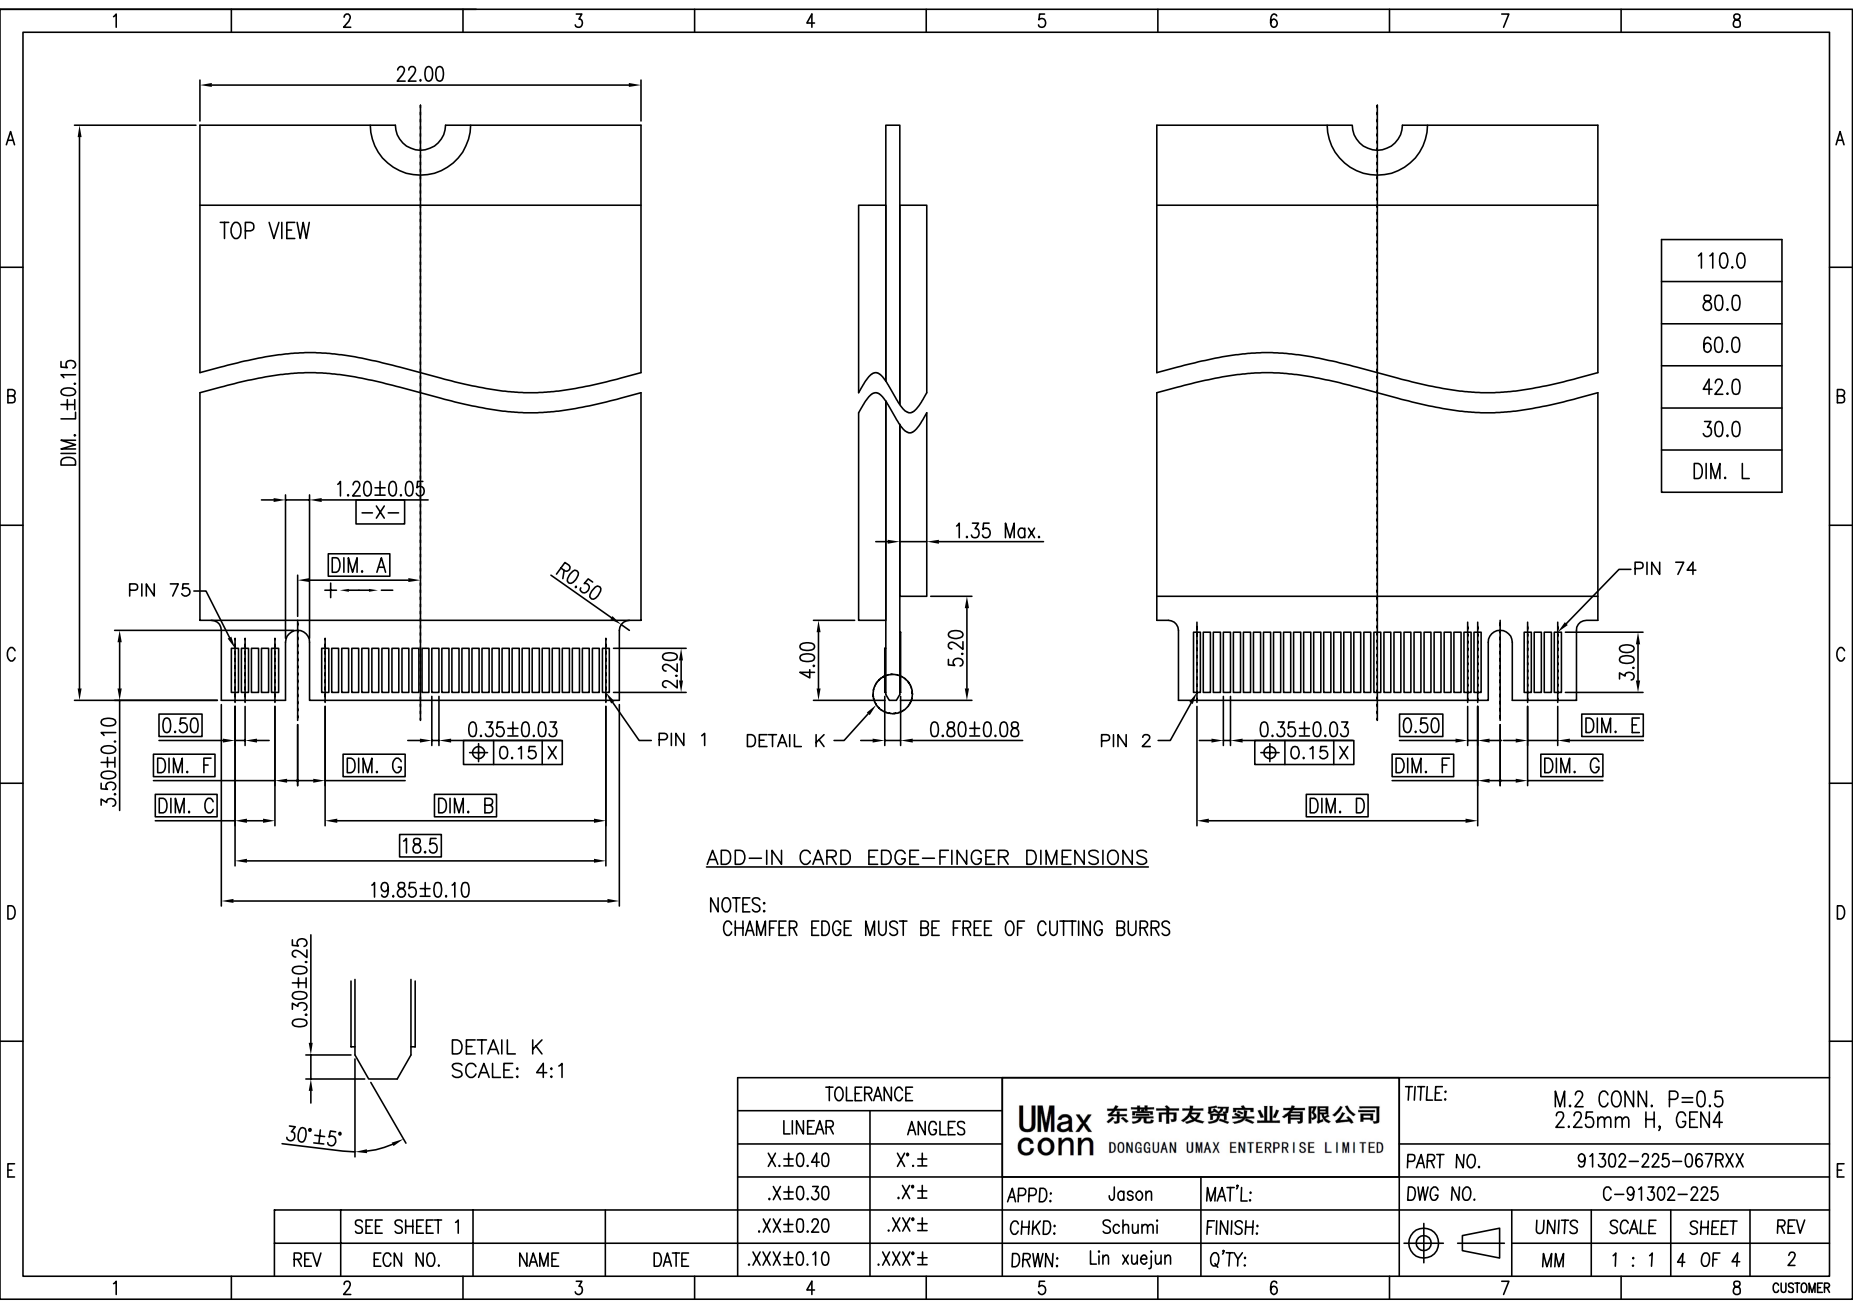
[picture p107: page 4]
