IdealFox/Type_C-SSD-Box/(list of files, drawings)

Other design files:
PCB工程/ver1.0/Altium工程_Type_C硬盘盒_2025-09-27_14-32-02_2025-10-01/Type_C硬盘盒_2025-09-27_14-32-02/1_P1.schdoc
PCB工程/ver1.0/Altium工程_Type_C硬盘盒_2025-09-27_14-32-02_2025-10-01/Type_C硬盘盒_2025-09-27_14-32-02/PCB1.pcbdoc
PCB工程/ver1.0/Altium工程_Type_C硬盘盒_2025-09-27_14-32-02_2025-10-01/Type_C硬盘盒_2025-09-27_14-32-02/PCB1.PcbLib
PCB工程/ver1.0/Altium工程_Type_C硬盘盒_2025-09-27_14-32-02_2025-10-01/Type_C硬盘盒_2025-09-27_14-32-02/PCB1_ASCII.pcbdoc
PCB工程/ver1.0/Altium工程_Type_C硬盘盒_2025-09-27_14-32-02_2025-10-01/Type_C硬盘盒_2025-09-27_14-32-02/Type_C硬盘盒.PrjPcb
PCB工程/ver1.0/Type_C硬盘盒_2025-09-27_14-32-02.eprj
PCB工程/ver2.0/Altium_Type_C硬盘盒/1_P1.schdoc
PCB工程/ver2.0/Altium_Type_C硬盘盒/Type_C硬盘盒.PrjPcb
PCB工程/ver2.0/Altium_Type_C硬盘盒/第一版PCB.pcbdoc
PCB工程/ver2.0/Altium_Type_C硬盘盒/第二版PCB.pcbdoc
PCB工程/ver2.0/Altium_Type_C硬盘盒/第二版PCB.PcbLib
PCB工程/ver2.0/Altium_Type_C硬盘盒/第二版PCB_ASCII.pcbdoc
PCB工程/ver2.0/Type_C硬盘盒_2025-09-27_14-32-02.eprj
PCB工程/ver3.0/Altium_Type_C硬盘盒/1_P1.schdoc
PCB工程/ver3.0/Altium_Type_C硬盘盒/Type_C硬盘盒.PrjPcb
PCB工程/ver3.0/Altium_Type_C硬盘盒/第一版PCB.pcbdoc
PCB工程/ver3.0/Altium_Type_C硬盘盒/第三版PCB.pcbdoc
PCB工程/ver3.0/Altium_Type_C硬盘盒/第三版PCB_ASCII.pcbdoc
PCB工程/ver3.0/Altium_Type_C硬盘盒/第二版PCB.pcbdoc
PCB工程/ver3.0/Altium_Type_C硬盘盒/第二版PCB.PcbLib
PCB工程/ver3.0/Type_C硬盘盒_2025-09-27_14-32-02.eprj
复刻文件及说明/复刻文件/PCB/Type_C硬盘盒_2025-09-27_14-32-02.eprj
